plundis/ELEC-391/task2.ino

#include "Arduino_BMI270_BMM150.h"
#include <math.h>  // Include for atan2()

float x, y, z;
float xangle, yangle, zangle;
float degreesX = 0;
float degreesY = 0;
float theta, theta2;

void setup() {
  Serial.begin(9600);
  while (!Serial);
  Serial.println("Started");

  if (!IMU.begin()) {
    Serial.println("Failed to initialize IMU!");
    while (1);
  }

  Serial.print("Accelerometer sample rate = ");
  Serial.print(IMU.accelerationSampleRate());
  Serial.println(" Hz");
}

void loop() {
  if (IMU.accelerationAvailable()) {
    IMU.readAcceleration(x, y, z);

    // Calculate tilt in degrees
    // degreesX = atan2(x, sqrt(y * y + z * z)) * 180 / PI;
    // degreesY = atan2(y, sqrt(x * x + z * z)) * 180 / PI;

    // xangle = x * 180 / PI;
    // yangle = y * 180 / PI;
    // zangle = z * 180/ PI;

    theta = -atan2(y,z) * 180 / PI;

    // if (abs(xangle) < 10 && abs(zangle) < 10 && abs(zangle) > 0.01) {
    //     theta2 = xangle / zangle;
    // } else {
    //     theta2 = atan2(xangle, zangle);
    // }


    // Print tilt angles
    // Serial.print("X Tilt: ");
    // Serial.print(x);
    // Serial.print("°, Y Tilt: ");
    // Serial.print(degreesY);
    // Serial.println("°");
   // Serial.print("theta: ");
    Serial.print("Accelerometer angle: ");
  //Serial.print(acc_ang);
    Serial.println(theta);

    //Serial.println("°, theta2: ");
    // Serial.print(theta2);
    // Serial.println("°");
  }

  delay(100);  // Adjust sample rate
}
