plundis/ELEC-391/(commit log)

2025-01-17 Update and rename Accelerometer.ino to task2.ino
2025-01-17 Update and rename gyroscope_angle.ino to task3.ino
2025-01-17 Update and rename filtered_angle.ino to task4.ino
2025-02-07 Update task4.ino
    updated filtered code
2025-02-07 Add files via upload
    PoC PWM tests
2025-02-07 Add files via upload
    Accelerometer code with variable PWM test
2025-03-05 Ultrasonic Sensor + Speaker Code
2025-03-12 Add files via upload
    Arduino ble receiver code - v1. All buttons are pressed once for sending commands. The command runs until the next one is sent.
2025-03-14 Rename joystick_directions.ino to ESP32_Joystick_Directions.ino
    Working:
    - Forward
    - Left
    - Diagonals (Left-Forward, Left-Backward, Right-Forward)
    Not Fully Working:
    - Right
    - Backward
    - Diagonal (Right-Backward)
2026-10-04 Reorganize repo: final robot and remote code, README, archive
    Adds the final robot firmware (robot/robot.ino), the ESP32 remote
    (remote/remote.ino), the MATLAB tilt simulation and report images,
    plus a README explaining the project.
    Every earlier file is moved, not deleted, into archive/ with a short
    index of what each one was.
    [ARDUINO_PID_Controller_Test.ino, ARDUINO_Ultrasonic_Sensor.ino, ESP32_Joystick_Directions.ino, ESP32_Joystick_LCD.ino, PWM.ino, arduino_flutter_ble_receiver.ino, fast_decay_PWM.ino, remote.ino]
2026-10-04 Set the motor cut-off to 25 degrees
    The robot only recovers from tilts of about 10 degrees, so cutting the
    motors at 25 instead of 35 stops them sooner once a fall is certain.
    25 degrees also matches the final report and the project write-up.
